marangisto/Envelope/README.md

# Envelope
Eurorack Modular Envelope Generator
