marangisto/Envelope/Panel.dxf

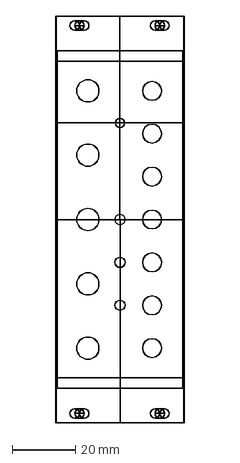
[picture p1: CAD file, 2018-08-18]
Panel.dxf
40.6 x 128.5 mm
