marangisto/Envelope/PWM.asc

C1: cap; 47n
C2: cap; 47n
C3: cap; 47n
R1: res; 1k
R2: res; 1k
R3: res; 1k
Vpwm: voltage; PULSE(0 5 0 30n 30n 16u 32u 100)
Named nets: 0, PWM
.tran 0 1m 0 5n
