marangisto/Envelope/Envelope.kicad_pcb

## KiCad design Envelope.kicad_pcb (2019-05-05)

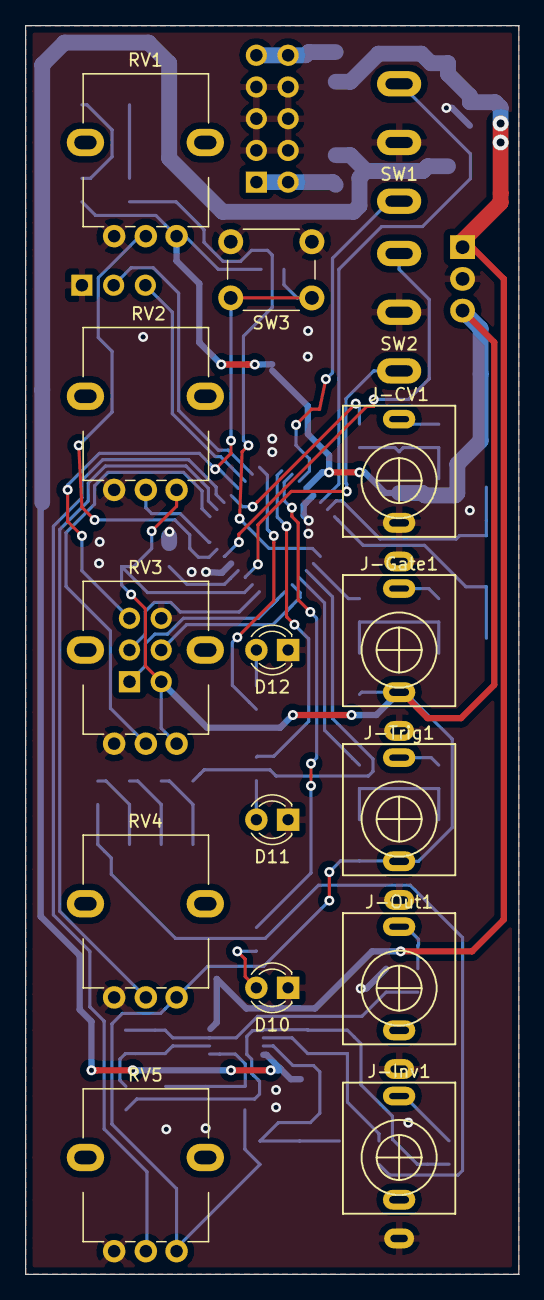
[picture p2: board Envelope.kicad_pcb from above]

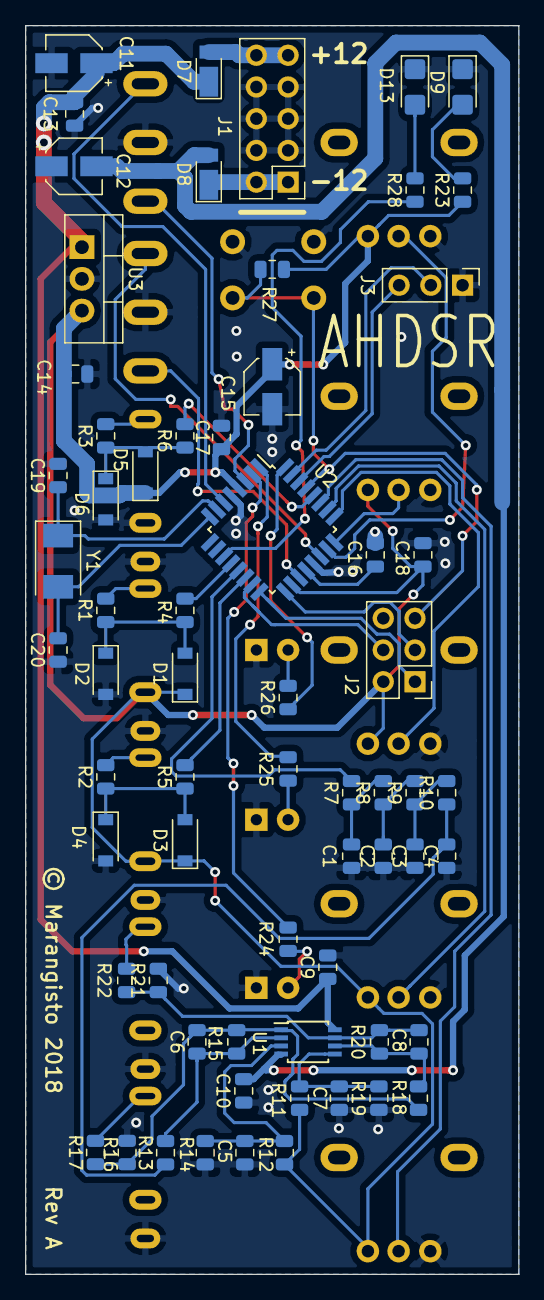
[picture p3: board Envelope.kicad_pcb from below]

Board: 2 copper layers, 39.5 x 100.0 mm, 81 parts (65 on the bottom side), 55 nets.

Parts:
C1, C2, C3, C4: 47n; C_0805_2012Metric
C5, C7, C9, C10, C13, C14, C16, C17, C18: 100n; C_0805_2012Metric
C6, C8: 470p; C_0805_2012Metric
C11, C12, C15: 10u; CP_Elec_4x5.8
C19, C20: 22p; C_0805_2012Metric
D1, D2, D3, D4, D5, D6: 1N5819; D_SOD-123
D7, D8: DFLR1400-7; D_PowerDI-123
D9, D13: LED; LED_1206_3216Metric_Castellated
D10, D11, D12: LED; LED_D3.0mm
J1: Conn_02x05_Odd_Even; PinHeader_2x05_P2.54mm_Vertical
J2: Conn_02x03_Odd_Even; PinHeader_2x03_P2.54mm_Vertical
J3: Conn_01x03; PinHeader_1x03_P2.54mm_Vertical
J-CV1: AudioJack2_Ground_Switch; PJ398SM
J-Gate1: AudioJack2_Ground_Switch; PJ398SM
J-Inv1: AudioJack2_Ground_Switch; PJ398SM
J-Out1: AudioJack2_Ground_Switch; PJ398SM
J-Trig1: AudioJack2_Ground_Switch; PJ398SM
R1, R2, R3, R4, R5, R6: 33k; R_0805_2012Metric
R7, R8, R9, R10, R17, R22: 1k; R_0805_2012Metric
R11, R12, R13, R14, R15, R18, R19, R20: 47k; R_0805_2012Metric
R16, R21: 100k; R_0805_2012Metric
R23, R24, R25, R26, R28: 330; R_0805_2012Metric
R27: 10k; R_0805_2012Metric
RV1, RV2, RV3, RV4, RV5: 100k; AlpsRK09K
SW1, SW2: SW_SPDT_MSM; SP1MS1
SW3: SW_Push; SW_PUSH_6mm_H9.5mm
U1: TL072; TSSOP-8_3x3mm_P0.65mm
U2: ATmega328PB-AU; TQFP-32_7x7mm_P0.8mm
U3: L7805; TO-220-3_Vertical
Y1: 20MHz; Crystal_SMD_Abracon_ABM3-2Pin_5.0x3.2mm

Connections:
+5V: C14.1, C15.1, C17.1, C18.2, D1.1, D3.1, D5.1, J2.2, J-Gate1.TN, J-Trig1.TN, R11.2, R12.2, R23.1, R27.1, RV1.1, RV2.1, RV3.1, RV4.1, RV5.1, U2.4, U2.18, U3.3
+12V: C9.1, C11.1, C13.1, D7.1, U1.8, U3.1
-12V: C10.2, C12.2, D8.2, U1.4
/MCU328/PB0: R4.1, U2.12
/MCU328/PB1: R7.2, U2.13
/MCU328/PB2: R5.1, U2.14
/MCU328/PC0: RV1.2, U2.23
/MCU328/PC1: RV2.2, U2.24
/MCU328/PC2: RV3.2, U2.25
/MCU328/PC3: RV4.2, U2.26
/MCU328/PC4: RV5.2, U2.27
/MCU328/PC5: R6.1, U2.28
/MCU328/PD2: R26.1, U2.32
/MCU328/PD3: R25.1, U2.1
/MCU328/PD4: R24.1, U2.2
/MCU328/PD7: R28.1, U2.11
/MCU328/PE0: SW1.1, U2.3
/MCU328/PE1: SW1.3, U2.6
/MCU328/PE2: SW2.1, U2.19
/MCU328/PE3: SW2.3, U2.22
/MCU328/RXD/PD0: J3.3, U2.30
/MCU328/TXD/PD1: J3.2, U2.31
GND: C1.2, C2.2, C3.2, C4.2, C5.2, C7.2, C9.2, C10.1, C11.2, C12.1, C13.2, C14.2, C15.2, C16.1, C17.2, C18.1, C19.1, C20.1, D2.2, D4.2, D6.2, D9.1, D10.1, D11.1, D12.1, D13.1, J1.3, J1.4, J1.5, J1.6, J1.7, J1.8, J2.6, J3.1, J-CV1.S, J-CV1.TN, J-Gate1.S, J-Inv1.S, J-Out1.S, J-Trig1.S, R14.1, R16.2, R19.1, R21.2, RV1.3, RV2.3, RV3.3, RV4.3, RV5.3, SW1.2, SW2.2, SW3.2, U2.5, U2.21, U3.2
unnamed: C1.1, R7.1, R8.2
unnamed: C2.1, R8.1, R9.2
unnamed: C3.1, R9.1, R10.2
unnamed: C4.1, R10.1, R13.2
unnamed: C5.1, R12.1, R14.2, U1.3
unnamed: C6.1, R15.1, R16.1, R17.2, R18.2, U1.1
unnamed: C6.2, R13.1, R15.2, U1.2
unnamed: C7.1, R11.1, R19.2, U1.5
unnamed: C8.1, R20.1, R21.1, R22.2, U1.7
unnamed: C8.2, R18.1, R20.2, U1.6
unnamed: C16.2, U2.20
unnamed: C19.2, U2.7, Y1.1
unnamed: C20.2, U2.8, Y1.2
unnamed: D1.2, D2.1, R1.1, R4.2
unnamed: D3.2, D4.1, R2.1, R5.2
unnamed: D5.2, D6.1, R3.1, R6.2
unnamed: D7.2, J1.9, J1.10
unnamed: D8.1, J1.1, J1.2
unnamed: D9.2, R23.2
unnamed: D10.2, R24.2
unnamed: D11.2, R25.2
unnamed: D12.2, R26.2
unnamed: D13.2, R28.2
unnamed: J2.1, U2.16
unnamed: J2.3, U2.17
unnamed: J2.4, U2.15
unnamed: J2.5, R27.2, SW3.1, U2.29
unnamed: J-CV1.T, R3.2
unnamed: J-Gate1.T, R1.2
unnamed: J-Inv1.T, R17.1
unnamed: J-Out1.T, R22.1
unnamed: J-Trig1.T, R2.2
