marangisto/Envelope/src/Main.cpp

#define NO_TIMER_VECTORS 1
#include <Main.h>
#include <Delay.h>
#include <Timer.h>
#include <ADC.h>
#include <Pins.h>

template <class T> const T& max(const T& a, const T& b) { return (a<b) ? b : a; }
template <class T> const T& min(const T& a, const T& b) { return (a<b) ? a : b; }

static uint32_t map(uint32_t x, uint32_t in_min, uint32_t in_max, uint32_t out_min, uint32_t out_max)
{
    return (x - in_min) * (out_max - out_min + 1) / (in_max - in_min + 1) + out_min;
}

typedef output_t<PD, 2> led_gate;
typedef output_t<PD, 3> led_trig;
typedef output_t<PD, 4> led_out;
typedef output_t<PD, 7> led_rear;

typedef input_t<PB, 0> gate;
typedef input_t<PB, 2> trig;

typedef input_t<PE, 0, enable_pullup> sw_1a;
typedef input_t<PE, 1, enable_pullup> sw_1b;
typedef input_t<PE, 2, enable_pullup> sw_2a;
typedef input_t<PE, 3, enable_pullup> sw_2b;

typedef timer_t<0> time;
typedef timer_t<1> pwm;
typedef timer_t<2> aux;

static const int adc_a = 0;
static const int adc_h = 1;
static const int adc_d = 2;
static const int adc_s = 3;
static const int adc_r = 4;

static const uint8_t env_lin[] =
    { 0,1,2,3,4,5,6,7,8,9,10,11,12,13,14,15,16,17,18,19,20,21,22,23,24,25,26,27,28,29,30,31
    , 32,33,34,35,36,37,38,39,40,41,42,43,44,45,46,47,48,49,50,51,52,53,54,55,56,57,58,59,60,61,62,63
    , 64,65,66,67,68,69,70,71,72,73,74,75,76,77,78,79,80,81,82,83,84,85,86,87,88,89,90,91,92,93,94,95
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
static volatile uint16_t free_count = 0;

ISR(TIMER0_COMPA_vect)
{
    static uint8_t i = 0;
    static uint32_t k = 0;
    static uint32_t n = 255;
    static uint8_t v = 0;
    static uint8_t start_v = 0;
    static uint8_t sustain = 0;

    if (++i == 0)
        led_rear::toggle();

    switch (g_state)
    {
    case s_start:
        g_state = s_attack;
        n = g_counts[g_state];
        k = 0;
        start_v = v;
        sustain = g_counts[s_sustain] >> 2;
        if (free_run)
        {
            led_gate::set();
            led_trig::clear();
        }
        break;
    case s_attack:
        if (k > n)
        {
            g_state = g_counts[s_hold] > 0 ? s_hold : s_decay;
            n = g_counts[g_state];
            k = 0;
            start_v = v;
            if (free_run)
            {
                led_gate::clear();
                led_trig::set();
            }
        }
        else
        {
            uint8_t j = k < n ? ((uint32_t) k << 8) / n : 255;

            v = map(g_env[j], 0, 255, start_v, 255);
        }
        break;
    case s_hold:
        if (k > n)
        {
            g_state = s_decay;
            n = g_counts[g_state];
            k = 0;
            start_v = v;
        }
        break;
    case s_decay:
        if (k > n)
        {
            g_state = free_run ? s_start : (sustain ? s_sustain : s_stop);
            n = g_counts[g_state];
            k = 0;
            start_v = v;
        }
        else
        {
            uint8_t j = k < n ? ((uint32_t) k << 8) / n : 255;

            v = map(g_env[j], 0, 255, start_v, sustain);
        }
        break;
    case s_sustain:
        if (!g_gate)
        {
            g_state = s_release;
            n = g_counts[g_state];
            k = 0;
            start_v = v;
        }
        break;
    case s_release:
        if (k > n)
        {
            g_state = s_stop;
            v = 0;
        }
        else
        {
            uint8_t j = k < n ? ((uint32_t) k << 8) / n : 255;

            v = map(g_env[j], 0, 255, start_v, 0);
        }
        break;
    default:
        v = 0;
    }

    pwm::output_compare_register<channel_a>() = v;

    ++k;
}

ISR(TIMER2_OVF_vect)
{
    static uint8_t i = 0;
    static const uint16_t free_start = 100;

    led_out::write(i++ < pwm::output_compare_register<channel_a>());
    bool g = gate::read();
    bool t = trig::read();

    if (!free_run)
    {
        led_gate::write(g);
        led_trig::write(t);
    }

    if (!i)
    {
        if (!free_run && g_state == s_stop && free_count == free_start)
        {
            free_run = true;
            g_state = s_start;
        }
        else if (free_count < free_start && g && t)
            ++free_count;
    }
}

ISR(PCINT0_vect)
{
    static bool last_gate = false;

    g_gate = gate::read();

    if (g_gate != last_gate)
    {
        if (g_gate)
            g_state = s_start;
        last_gate = g_gate;
        led_gate::write(g_gate);
        free_count = 0;
        free_run = false;
    }
}


static const uint8_t time_prescale = 8;
static const float time_period = time_prescale / F_CPU;
static const float time_tick = 250e-6;    // in seconds
static const uint8_t time_count = static_cast<uint8_t>(time_tick / time_period) - 1;
static const float ticks_per_second = F_CPU / (time_prescale * (time_count + 1));
static const int adc_max = 1023;

static uint32_t count(float x, float tmax)
{
    float k = tmax * ticks_per_second / (adc_max * (float) adc_max);

    return k * x * x;
}

void setup()
{
    led_gate::setup();
    led_trig::setup();
    led_out::setup();
    led_rear::setup();
    gate::setup();
    trig::setup();
    adc::setup<128>();

    const wg_mode mode = pwm_phase_correct;
    const int prescale = 1;

    pwm::setup<mode, top_0xff>();
    pwm::clock_select<prescale>();
    pwm::output_pin<channel_a>::setup();
    pwm::compare_output_mode<channel_a, clear_on_compare_match>();

    time::setup<ctc_mode, top_ocra>();
    time::clock_select<time_prescale>();
    time::output_compare_register<channel_a>() = time_count; // 250ms period
    time::enable_oca();

    aux::setup<normal_mode>();
    aux::clock_select<1>();
    aux::enable();

    PCMSK0 |= _BV(PCINT0);
    PCICR |= _BV(PCIE0);

    sei();
}

void loop()
{
    static uint8_t i = 0;
    float tmax = 0;

    if (!sw_1a::read())
        tmax = 1;                   // fast
    else if (!sw_1b::read())
        tmax = 1000;                // slow
    else
        tmax = 20;                  // medium

    if (!sw_2a::read())
        g_env = env_sin;
    else if (!sw_2b::read())
        g_env = env_exp;
    else
        g_env = env_lin;

    g_counts[s_attack] = 1 + count(adc::read<adc_a>(), tmax);
    g_counts[s_hold] = count(adc::read<adc_h>(), tmax);
    g_counts[s_decay] = 1 + count(adc::read<adc_d>(), tmax);
    g_counts[s_sustain] = adc::read<adc_s>();
    g_counts[s_release] = count(adc::read<adc_r>(), tmax);

    i++;
}
