marangisto/Envelope/(commit log)

2018-07-26 Empty schematic and board outline.
    [Envelope.kicad_pcb, Envelope.sch]
2018-07-26 Added reusable AtMega328 subschema.
    [Envelope.sch, MCU328.sch]
2018-07-27 More sub-modules.
    [Envelope.sch, MCU328.sch, POW5V.sch]
2018-07-28 Lots of further work.
    [Envelope.kicad_pcb, Envelope.sch, MCU328.sch, POW5V.sch]
2018-08-04 Upgraded to KiCad 5.
    [Envelope-2018-08-04-13-00-04.sch, MCU328-2018-08-04-13-00-04.sch, POW5V-2018-08-04-13-00-04.sch]
2018-08-08 Use new jacks.
    [Envelope.kicad_pcb, Envelope.sch, MCU328.sch, POW5V.sch]
2018-08-09 Assigned more footprints.
    [Envelope.kicad_pcb, Envelope.sch, POW5V.sch]
2018-08-16 Finished schema and footprint assignments.
    [Envelope.kicad_pcb, Envelope.sch, MCU328.sch, OpAmp.xlsx, POW5V.sch]
2018-08-16 Panel drawing and initial placement.
    [Panel.dxf]
2018-08-16 All components place on board but no routing.
    [Envelope.kicad_pcb, Envelope.sch, MCU328.sch, POW5V.sch]
2018-08-16 More adjustments on placement.
    [Envelope.kicad_pcb]
2018-08-18 Started routing.
    [Envelope.kicad_pcb, MCU328.sch]
2018-08-18 Routed most signals.
    [Envelope.kicad_pcb]
2018-08-18 Use 3-pin connector for serial.
    [Envelope.kicad_pcb, MCU328.sch]
2018-08-18 Routed power.
    [Envelope.kicad_pcb]
2018-08-18 Corrected position of reset button.
    [Envelope.kicad_pcb, Panel.dxf]
2018-08-18 Completed ground fills.
    [Envelope.kicad_pcb]
2018-08-18 Silk screens.
    [Envelope.kicad_pcb]
2018-08-18 Added gerbers.
    [Envelope-B.Cu.gbr, Envelope-B.Mask.gbr, Envelope-B.Paste.gbr, Envelope-B.SilkS.gbr, Envelope-Edge.Cuts.gbr, Envelope-F.Cu.gbr, Envelope-F.Mask.gbr, Envelope-F.SilkS.gbr]
2018-08-19 Connect CV TN to ground to avoid drift.
    [Envelope-B.Cu.gbr, Envelope-B.Mask.gbr, Envelope-B.Paste.gbr, Envelope-B.SilkS.gbr, Envelope-Edge.Cuts.gbr, Envelope-F.Cu.gbr, Envelope-F.Mask.gbr, Envelope-F.SilkS.gbr]
2018-09-06 Added BOM.
2018-09-06 Reinstated BOM.
2018-09-08 Use csv for BOM.
    [Envelope.csv]
2018-11-07 Added 3-d models.
    [Envelope.kicad_pcb]
