marangisto/Envelope/(notices)

Notices in the files:
Envelope.kicad_pcb:
© Marangisto 2018
